mieuhong08032002/rtos_esp32_sht30_kotlin_firebase/README.md

64841951-a3d2-443d-8b06-7bbee6f5e3de
c4732968-f66f-41e9-833e-0a4640f3baea
